tfabris/LED-Controller/(list of files, cad)

Other CAD files:
3D Prints/Baseboard Cord Cover/Baseboard Wiring Cover.blend
3D Prints/Enclosure/Enclosure Master Bedroom.blend
