tfabris/LED-Controller/3D Prints/Baseboard Cord Cover/Photo - baseboard.jpg

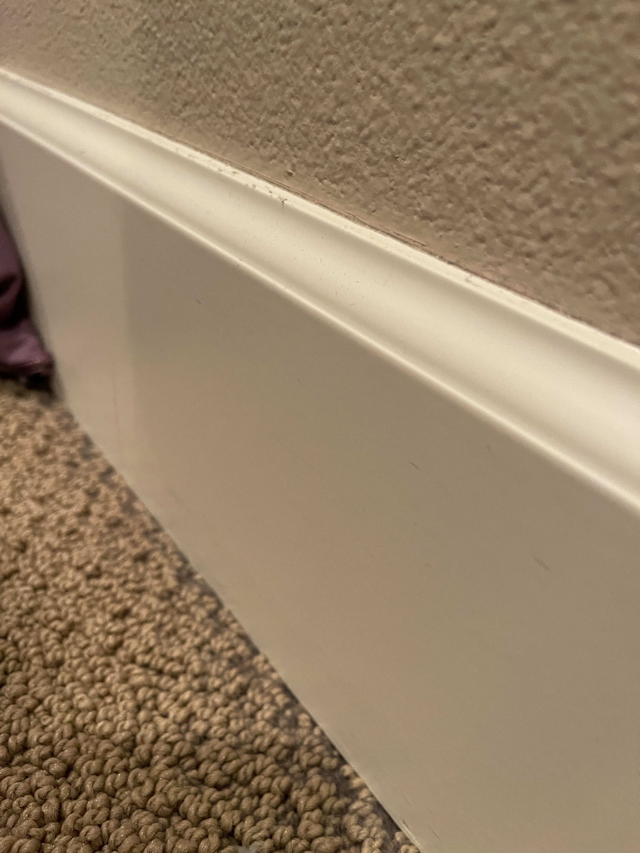
3D Prints/Baseboard Cord Cover/Photo - baseboard.jpg
