tfabris/LED-Controller/Schematics/Arduino Schematic.pdf

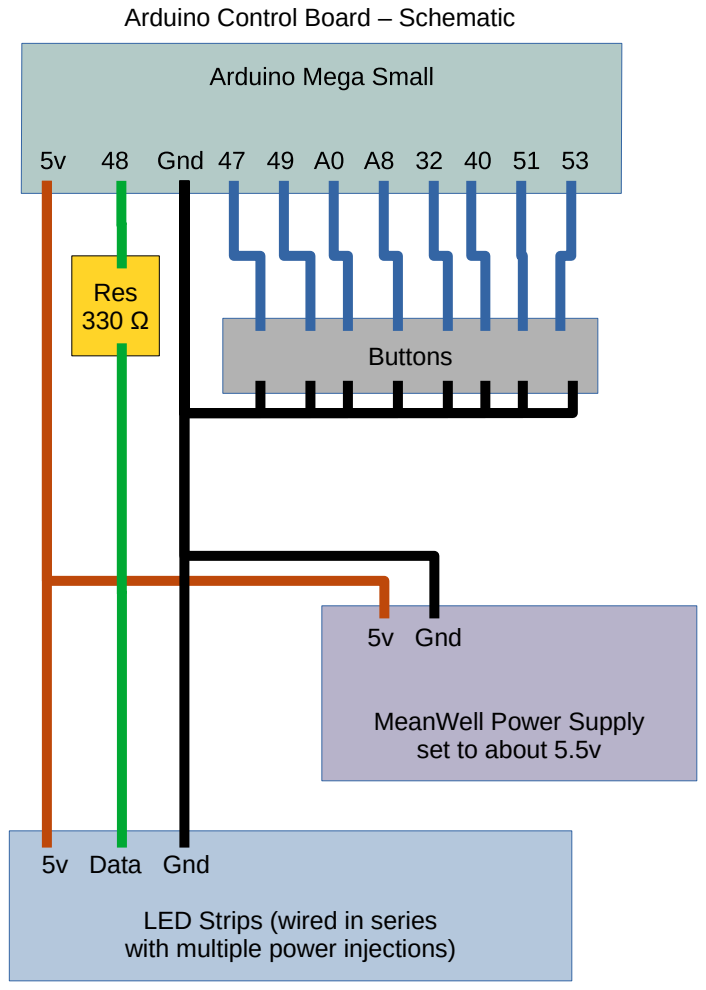
[picture p7: page 1]
5v Gnd; 5v Data Gnd; Buttons; Res 330 Ω

Arduino Control Board – Schematic

MeanWell Power Supply
set to about 5.5v

LED Strips (wired in series
with multiple power injections)
