tfabris/LED-Controller/Schematics/Wiring Diagram.pdf

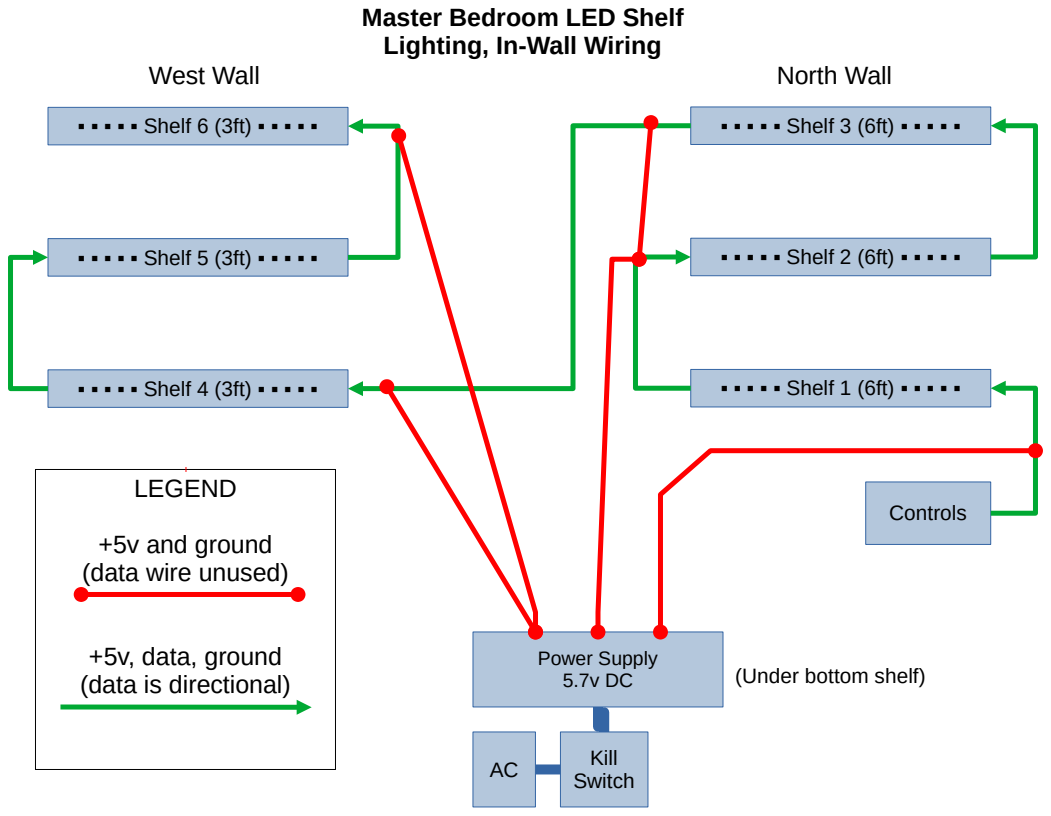
[picture p8: page 1]
Power Supply 5.7v DC; ▪ ▪ ▪ ▪ ▪ Shelf 1 (6ft) ▪ ▪ ▪ ▪ ▪; Controls; Kill; Switch; ▪ ▪ ▪ ▪ ▪ Shelf 6 (3ft) ▪ ▪ ▪ ▪ ▪; ▪ ▪ ▪ ▪ ▪ Shelf 5 (3ft) ▪ ▪ ▪ ▪ ▪; ▪ ▪ ▪ ▪ ▪ Shelf 4 (3ft) ▪ ▪ ▪ ▪ ▪; ▪ ▪ ▪ ▪ ▪ Shelf 3 (6ft) ▪ ▪ ▪ ▪ ▪; ▪ ▪ ▪ ▪ ▪ Shelf 2 (6ft) ▪ ▪ ▪ ▪ ▪; West Wall; North Wall; LEGEND

Master Bedroom LED Shelf
Lighting, In-Wall Wiring

+5v and ground
(data wire unused)

+5v, data, ground
(data is directional)

(Under bottom shelf)
